ut-ras/pb-HW/(list of files, cad)

Other CAD files:
Bots/body v10.f3d
Bots/body v9.f3d
Bots/body2.0 v4.f3d
Bots/coupler2.0 v6.f3d
Bots/coupler2.0copy v2.f3d
Bots/midbody v7.f3d
Bots/stage0 v2.f3d
Bots/topbody v6.f3d
