ut-ras/pb-HW/Boards/tests/MC-test-simple.brd

## EAGLE design Boards/tests/MC-test-simple.brd (2018-04-29)

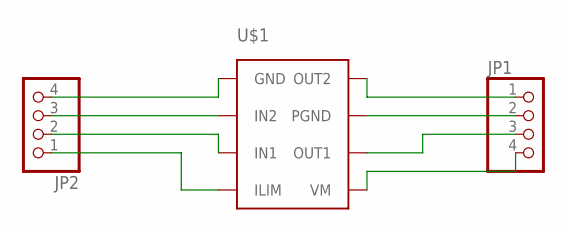
[picture p3: schematic MC-test-simple.sch]

Parts:
JP1, JP2: PINHD-1X4; 1X04
U$1: DRV8871; SO-8_POWERPAD

Connections:
GND: JP1.2, JP2.4, U$1.1 (GND), U$1.7 (PGND)
ILIM: JP2.1, U$1.4 (ILIM)
IN1: JP2.2, U$1.3 (IN1)
IN2: JP2.3, U$1.2 (IN2)
OUT1: JP1.3, U$1.6 (OUT1)
OUT2: JP1.1, U$1.8 (OUT2)
VM: JP1.4, U$1.5 (VM)

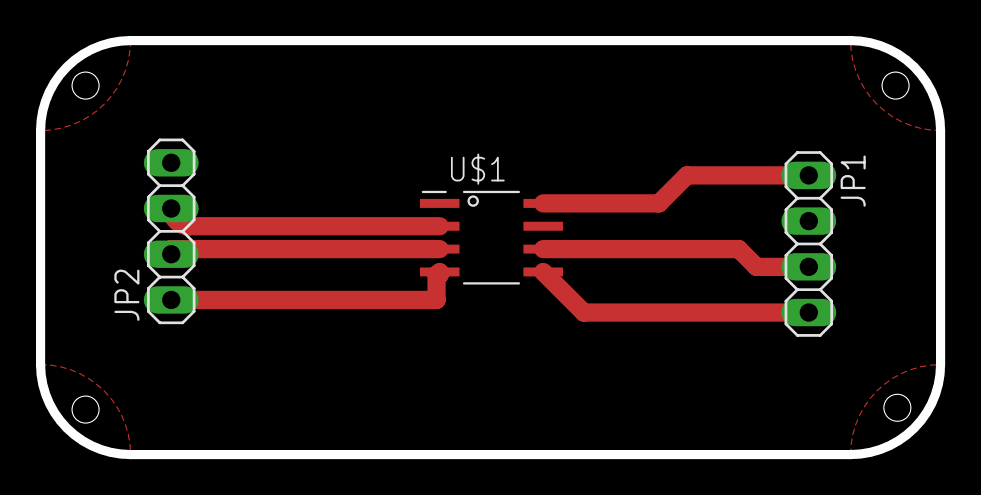
[picture p4: board MC-test-simple.brd from above]

Board: 2 copper layers, 50.0 x 23.0 mm, 3 parts (0 on the bottom side), 7 nets.
