ut-ras/pb-HW/Boards/robot/S1.brd

## EAGLE design Boards/robot/S1.brd (2018-04-29)

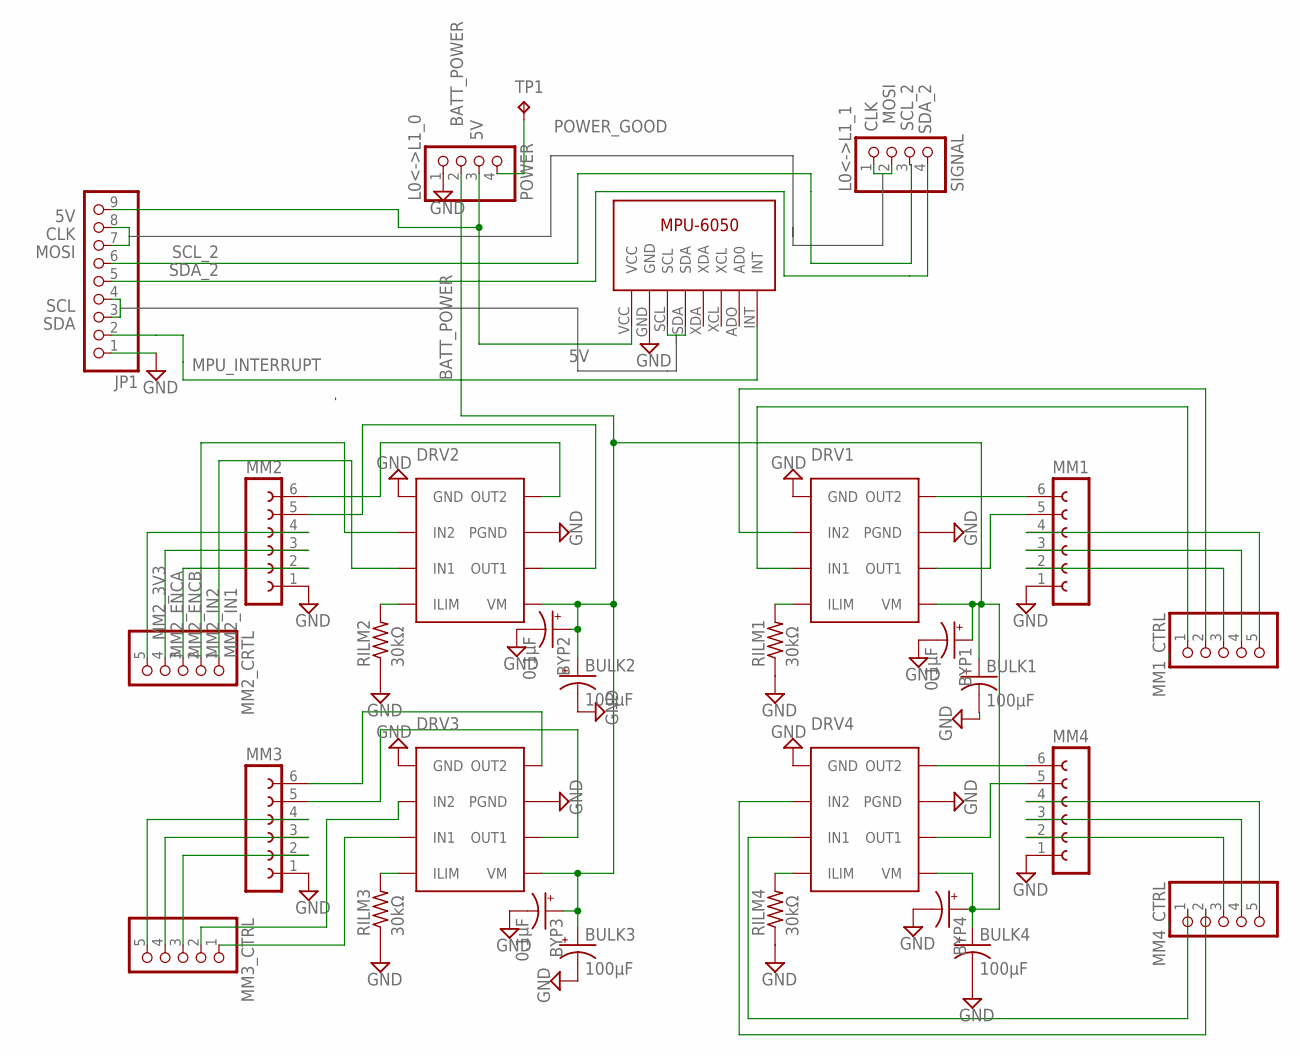
[picture p5: schematic S1.sch]

Parts:
BULK1, BULK2, BULK3, BULK4: 100μF; 153CLV-0605
BYP1, BYP2, BYP3: 0.1µF; A/3216-18R
BYP4: CPOL-USA/3216-18R; A/3216-18R
DRV1, DRV2, DRV3, DRV4: DRV8871; SO-8_POWERPAD
JP1: PINHD-1X9; 1X09
L0<->L1_0: POWER; 1X04/90
L0<->L1_1: SIGNAL; 1X04/90
MM1, MM2, MM3, MM4: FE06-1; FE06
MM1_CTRL, MM2_CRTL, MM3_CTRL, MM4_CTRL: PINHD-1X5; 1X05
RILM1, RILM2, RILM3, RILM4: 30kΩ; M1206
TP1: TPTP18R; TP18R
U$1: GY-521_MPUP6050; GY-521

Connections:
5V: JP1.9, L0<->L1_0.3, U$1.VCC
BATT_POWER: BULK1.+, BULK2.+, BULK3.+, BULK4.+, BYP1.+, BYP2.+, BYP3.+, BYP4.+, DRV1.5 (VM), DRV2.5 (VM), DRV3.5 (VM), DRV4.5 (VM), L0<->L1_0.2
CLK: JP1.8, L0<->L1_1.1
GND: BULK1.-, BULK2.-, BULK3.-, BULK4.-, BYP1.-, BYP2.-, BYP3.-, BYP4.-, DRV1.1 (GND), DRV1.7 (PGND), DRV2.1 (GND), DRV2.7 (PGND), DRV3.1 (GND), DRV3.7 (PGND), DRV4.1 (GND), DRV4.7 (PGND), JP1.1, L0<->L1_0.1, MM1.1, MM2.1, MM3.1, MM4.1, RILM1.1, RILM2.1, RILM3.1, RILM4.1, U$1.GND
IN1: DRV4.3 (IN1), MM4_CTRL.1
IN2: DRV4.2 (IN2), MM4_CTRL.2
MM2_3V3: MM2.4, MM2_CRTL.5
MM2_ENCA: MM2.3, MM2_CRTL.4
MM2_ENCB: MM2.2, MM2_CRTL.3
MM2_IN1: DRV2.3 (IN1), MM2_CRTL.1
MM2_IN2: DRV2.2 (IN2), MM2_CRTL.2
MOSI: JP1.7, L0<->L1_1.2
MPU_INTERRUPT: JP1.2, U$1.INT
unnamed: DRV3.4 (ILIM), RILM3.2
unnamed: DRV2.4 (ILIM), RILM2.2
unnamed: DRV1.4 (ILIM), RILM1.2
unnamed: DRV4.4 (ILIM), RILM4.2
unnamed: DRV4.8 (OUT2), MM4.6
unnamed: DRV3.6 (OUT1), MM3.5
unnamed: MM3.4, MM3_CTRL.5
unnamed: MM3.3, MM3_CTRL.4
unnamed: MM1.4, MM1_CTRL.5
unnamed: MM4.2, MM4_CTRL.3
unnamed: MM3.2, MM3_CTRL.3
unnamed: MM4.4, MM4_CTRL.5
unnamed: DRV2.8 (OUT2), MM2.6
unnamed: DRV2.6 (OUT1), MM2.5
unnamed: DRV3.8 (OUT2), MM3.6
unnamed: DRV4.6 (OUT1), MM4.5
unnamed: DRV1.6 (OUT1), MM1.5
unnamed: DRV1.8 (OUT2), MM1.6
unnamed: DRV3.2 (IN2), MM3_CTRL.2
unnamed: DRV3.3 (IN1), MM3_CTRL.1
unnamed: MM1.3, MM1_CTRL.4
unnamed: MM1.2, MM1_CTRL.3
unnamed: DRV1.2 (IN2), MM1_CTRL.2
unnamed: DRV1.3 (IN1), MM1_CTRL.1
unnamed: MM4.3, MM4_CTRL.4
POWER_GOOD: L0<->L1_0.4, TP1.TP
SCL: JP1.4, U$1.SCL
SCL_2: JP1.6, L0<->L1_1.3
SDA: JP1.3, U$1.SDA
SDA_2: JP1.5, L0<->L1_1.4

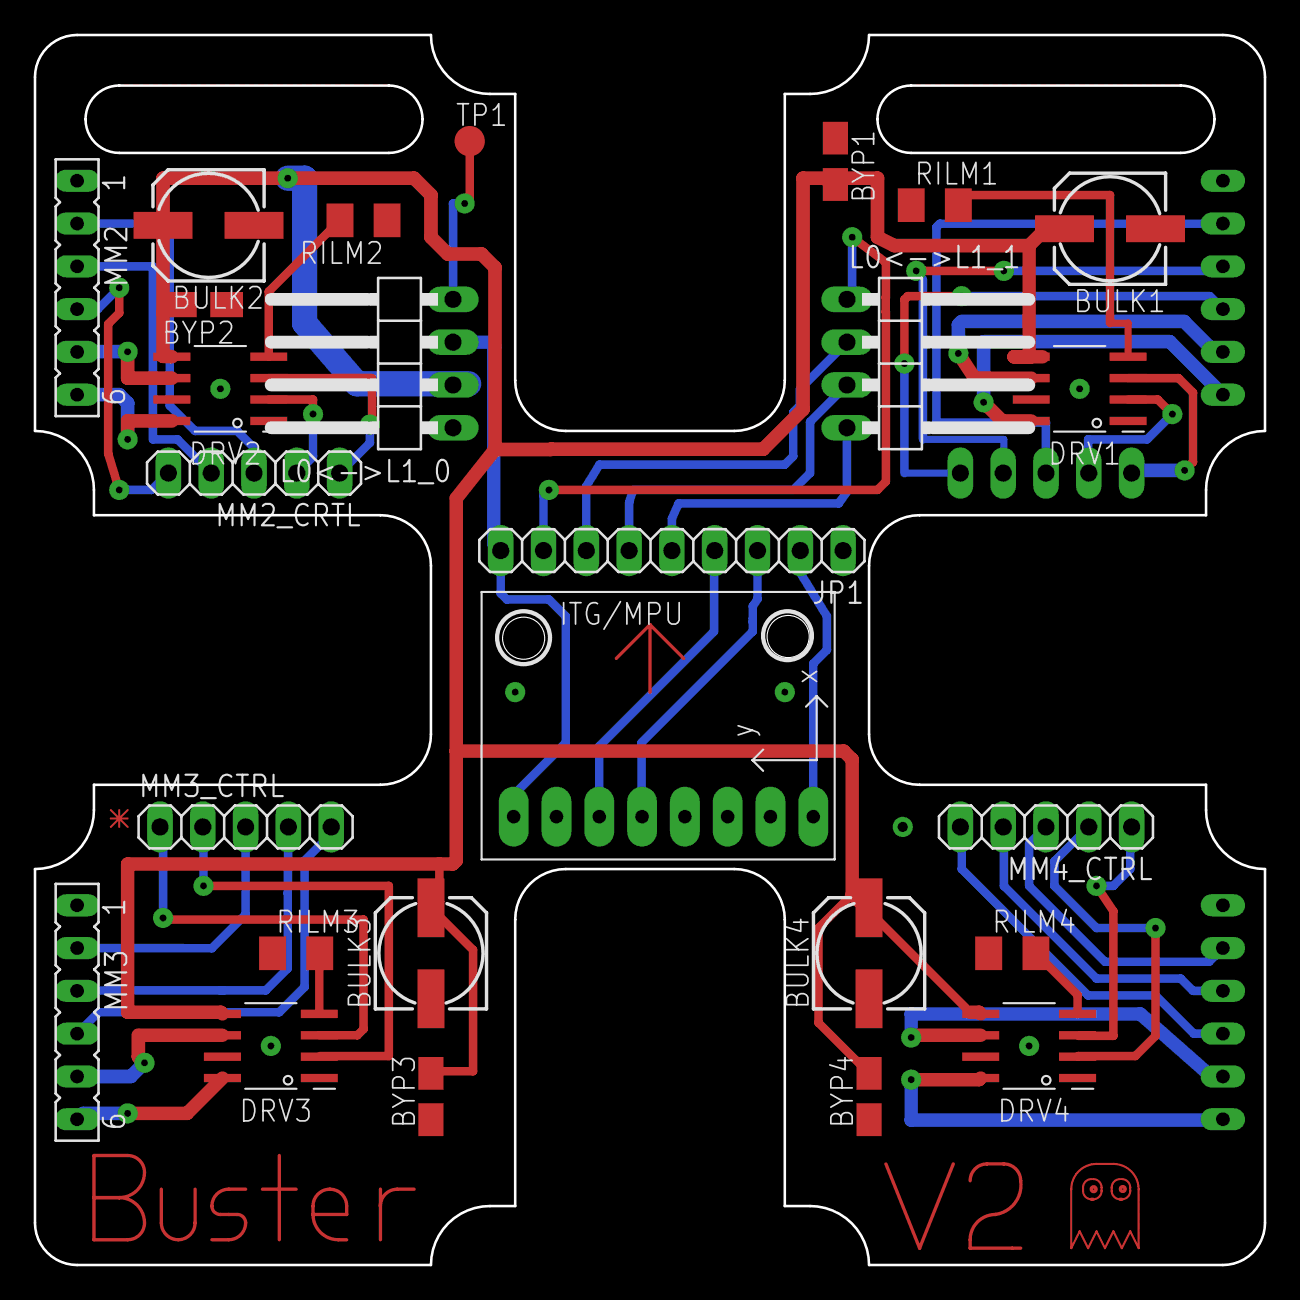
[picture p6: board S1.brd from above]

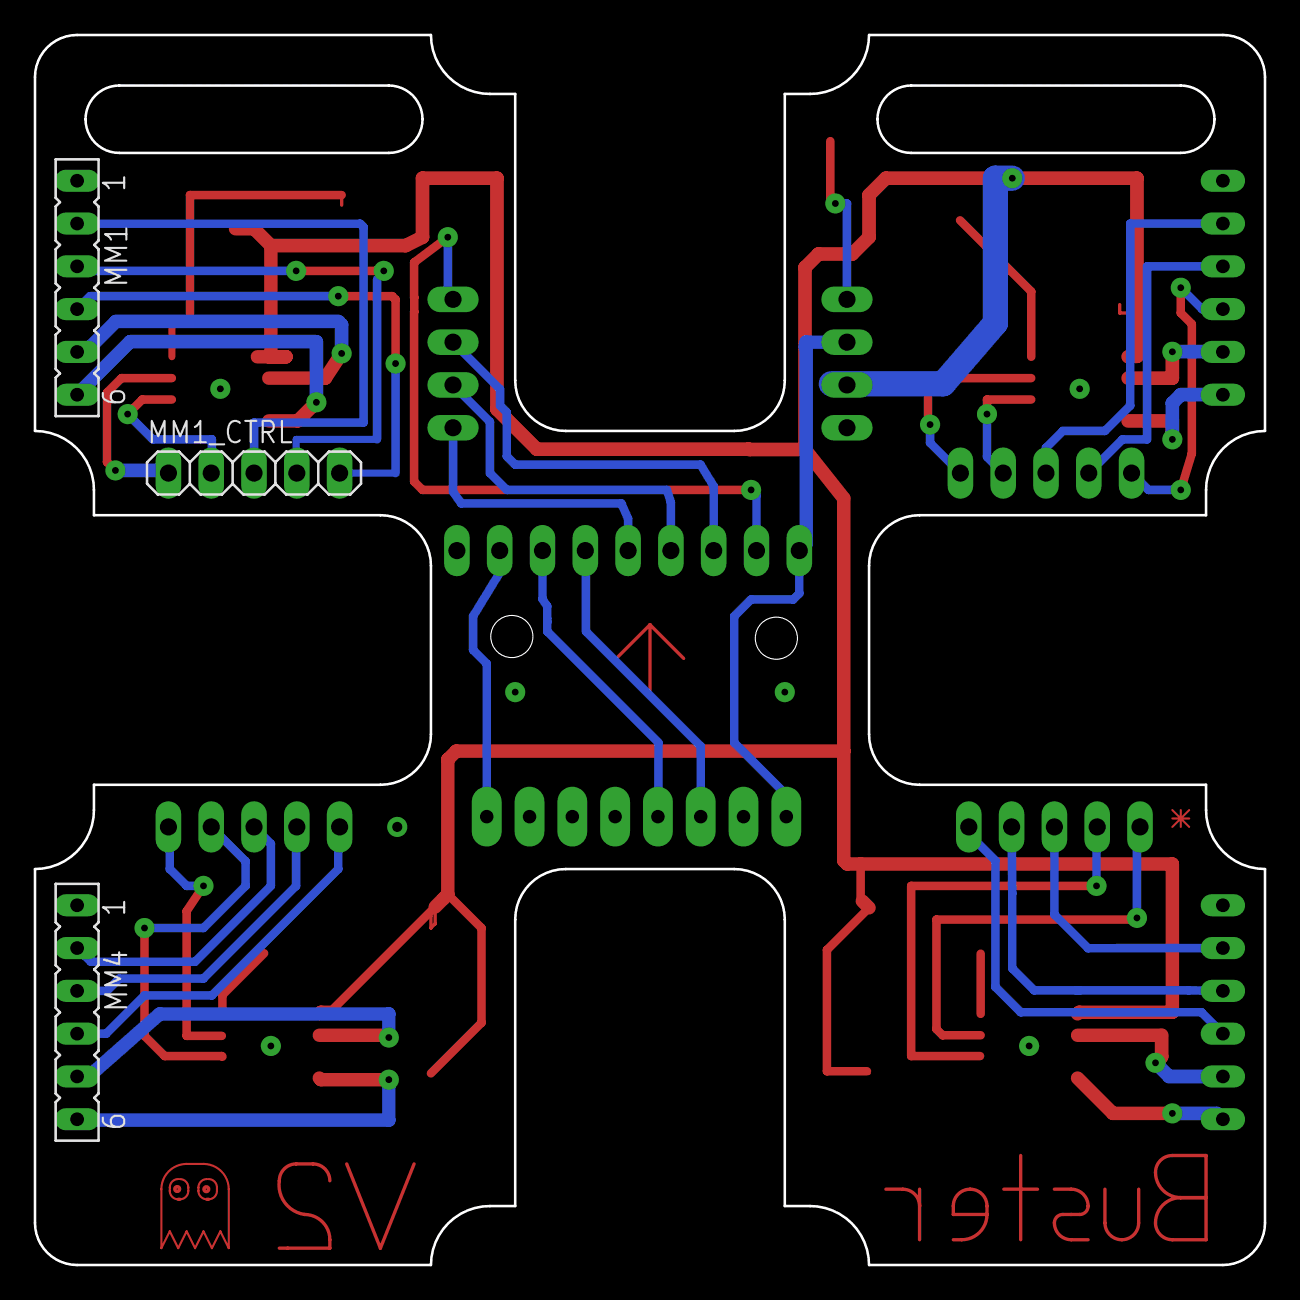
[picture p7: board S1.brd from below]

Board: 2 copper layers, 73.0 x 73.0 mm, 29 parts (3 on the bottom side), 43 nets.
