ut-ras/pb-HW/Boards/tests/MC-test.brd

## EAGLE design Boards/tests/MC-test.brd (2018-04-29)

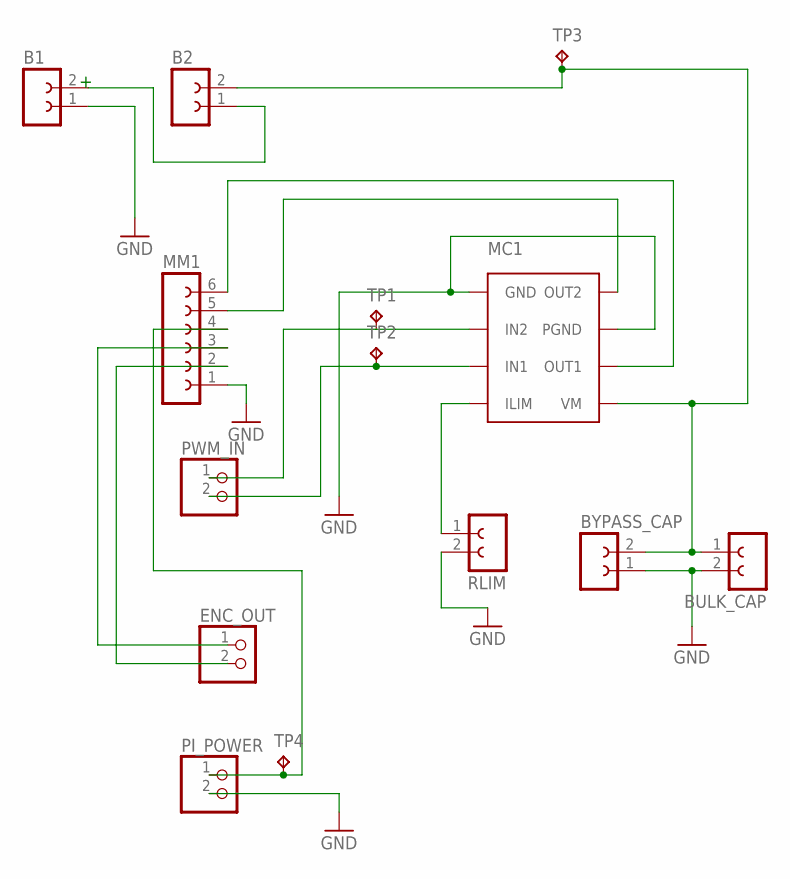
[picture p8: schematic MC-test.sch]

Parts:
B1, B2: FH_02X01
BULK_CAP: FH_02X01
BYPASS_CAP: FH_02X01
ENC_OUT: PINHD-1X2; 1X02
MC1: DRV8871; SO-8_POWERPAD
MM1: FE06-1; FE06
PI_POWER: PINHD-1X2; 1X02
PWM_IN: PINHD-1X2; 1X02
RLIM: FH_02X01
TP1, TP2, TP3, TP4: TPTP15SQ; TP15SQ

Connections:
3.3V: MM1.4, PI_POWER.1, TP4.TP
GND: B1.1, BULK_CAP.2, BYPASS_CAP.1, MC1.1 (GND), MC1.7 (PGND), MM1.1, PI_POWER.2, RLIM.2
M+: MC1.8 (OUT2), MM1.5
unnamed: ENC_OUT.1, MM1.3
unnamed: MC1.6 (OUT1), MM1.6
unnamed: B1.2, B2.1
unnamed: B2.2, BULK_CAP.1, BYPASS_CAP.2, MC1.5 (VM), TP3.TP
unnamed: MC1.4 (ILIM), RLIM.1
unnamed: ENC_OUT.2, MM1.2
unnamed: MC1.3 (IN1), PWM_IN.2, TP2.TP
unnamed: MC1.2 (IN2), PWM_IN.1, TP1.TP

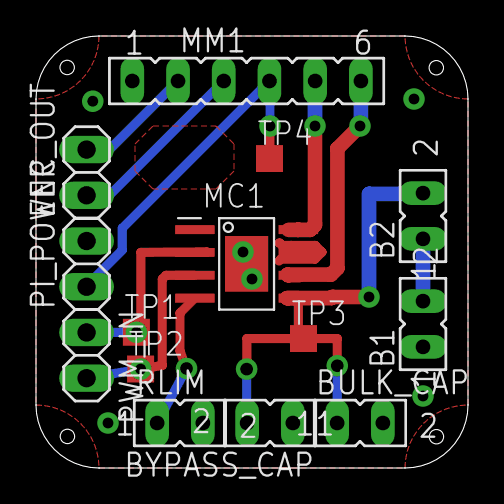
[picture p9: board MC-test.brd from above]

Board: 2 copper layers, 24.0 x 24.0 mm, 14 parts (0 on the bottom side), 11 nets.
