ut-ras/pb-HW/Boards/robot/S0.brd

## EAGLE design Boards/robot/S0.brd (2018-04-29)

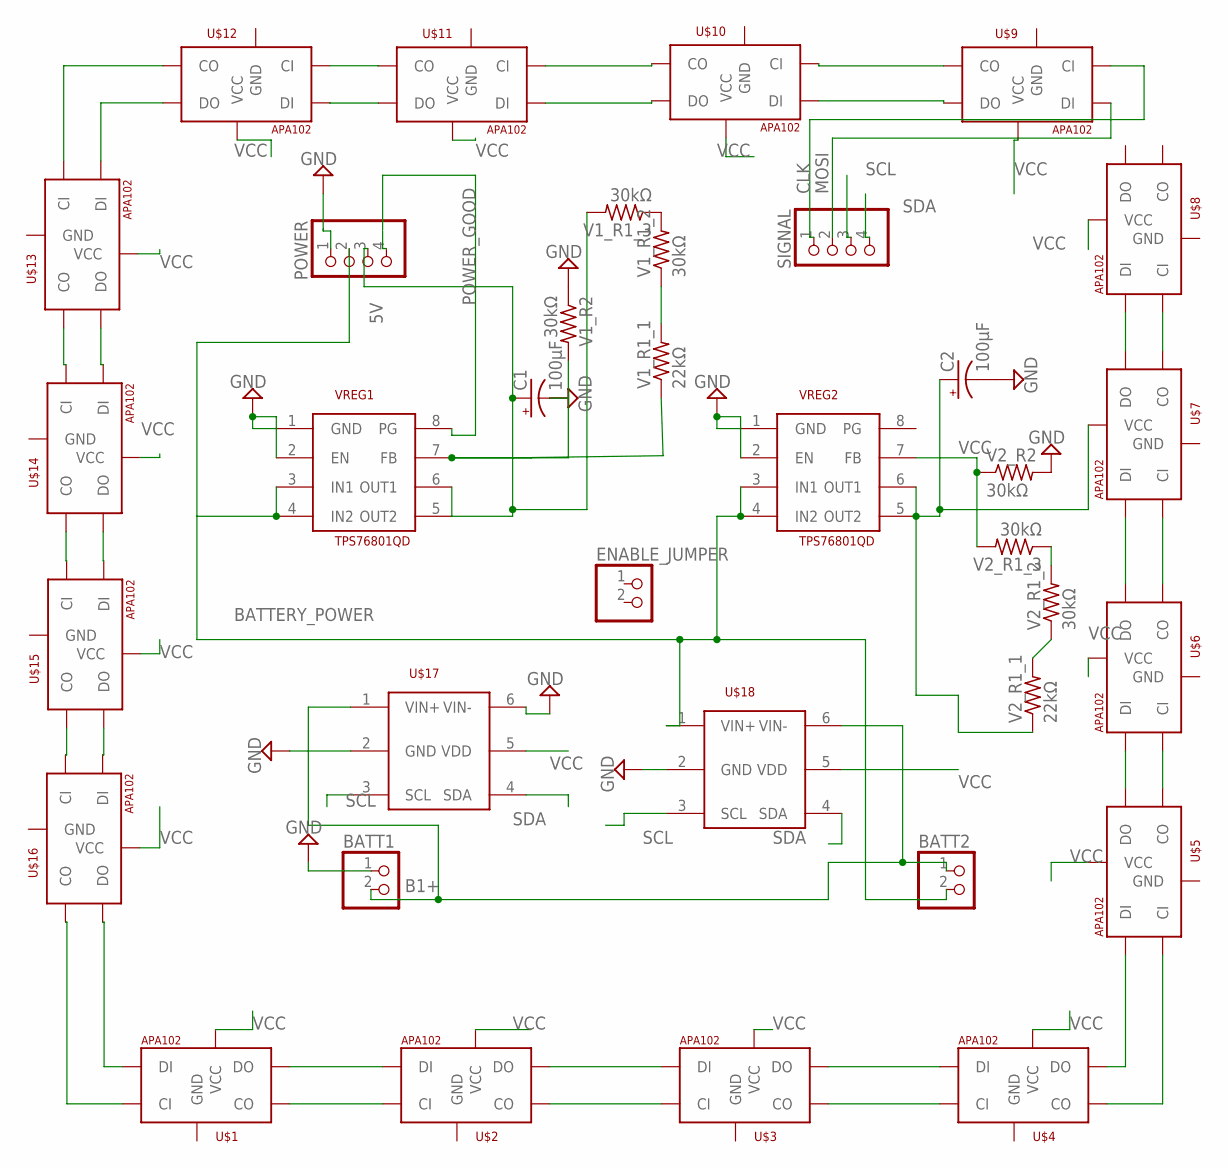
[picture p10: schematic S0.sch]

Parts:
BATT1, BATT2: PINHD-1X2/90; 1X02/90
C1, C2: 100µF; D/7343-31R
ENABLE_JUMPER: PINHD-1X2/90; 1X02/90
POWER: PINHD-1X4; 1X04
SIGNAL: PINHD-1X4; 1X04
U$1, U$2, U$3, U$4, U$5, U$6, U$7, U$8, U$9, U$10, U$11, U$12, U$13, U$14, U$15, U$16: APA1025050; APA102_5050
U$17: ADS1000BD0; SOT-23-6-DBV
U$18: ADS1000BD1; SOT-23-6-DBV
V1_R1_1, V2_R1_1: 22kΩ; R0402
V1_R1_2, V1_R1_3, V1_R2, V2_R1_2, V2_R1_3, V2_R2: 30kΩ; M1206
VREG1, VREG2: TPS76801QD; SO-8_POWERPAD

Connections:
5V: C1.+, POWER.3, V1_R1_3.2, VREG1.5 (OUT2), VREG1.6 (OUT1)
B1+: BATT1.2, BATT2.1, U$17.1 (VIN+), U$18.6 (VIN-)
BATTERY_POWER: BATT2.2, POWER.2, U$18.1 (VIN+), VREG1.3 (IN1), VREG1.4 (IN2), VREG2.3 (IN1), VREG2.4 (IN2)
CLK: SIGNAL.1, U$9.5 (CI)
GND: BATT1.1, C1.-, C2.-, POWER.1, U$1.6 (GND), U$2.6 (GND), U$3.6 (GND), U$4.6 (GND), U$5.6 (GND), U$6.6 (GND), U$7.6 (GND), U$8.6 (GND), U$9.6 (GND), U$10.6 (GND), U$11.6 (GND), U$12.6 (GND), U$13.6 (GND), U$14.6 (GND), U$15.6 (GND), U$16.6 (GND), U$17.2 (GND), U$17.6 (VIN-), U$18.2 (GND), V1_R2.1, VREG1.1 (GND), VREG1.2 (EN), VREG2.1 (GND), VREG2.2 (EN)
MOSI: SIGNAL.2, U$9.4 (DI)
unnamed: U$1.3 (DO), U$2.4 (DI)
unnamed: U$1.2 (CO), U$2.5 (CI)
unnamed: U$2.3 (DO), U$3.4 (DI)
unnamed: U$2.2 (CO), U$3.5 (CI)
unnamed: U$3.3 (DO), U$4.4 (DI)
unnamed: U$3.2 (CO), U$4.5 (CI)
unnamed: U$4.3 (DO), U$5.4 (DI)
unnamed: U$4.2 (CO), U$5.5 (CI)
unnamed: U$5.2 (CO), U$6.5 (CI)
unnamed: U$5.3 (DO), U$6.4 (DI)
unnamed: U$6.3 (DO), U$7.4 (DI)
unnamed: U$6.2 (CO), U$7.5 (CI)
unnamed: U$7.2 (CO), U$8.5 (CI)
unnamed: U$7.3 (DO), U$8.4 (DI)
unnamed: U$1.5 (CI), U$16.2 (CO)
unnamed: U$1.4 (DI), U$16.3 (DO)
unnamed: U$9.3 (DO), U$10.4 (DI)
unnamed: U$9.2 (CO), U$10.5 (CI)
unnamed: U$10.2 (CO), U$11.5 (CI)
unnamed: U$10.3 (DO), U$11.4 (DI)
unnamed: U$11.2 (CO), U$12.5 (CI)
unnamed: U$11.3 (DO), U$12.4 (DI)
unnamed: U$12.2 (CO), U$13.5 (CI)
unnamed: U$12.3 (DO), U$13.4 (DI)
unnamed: U$13.3 (DO), U$14.4 (DI)
unnamed: U$13.2 (CO), U$14.5 (CI)
unnamed: U$14.3 (DO), U$15.4 (DI)
unnamed: U$14.2 (CO), U$15.5 (CI)
unnamed: U$15.2 (CO), U$16.5 (CI)
unnamed: U$15.3 (DO), U$16.4 (DI)
unnamed: V2_R1_2.2, V2_R1_3.1
unnamed: V1_R1_1.2, V1_R1_2.1
unnamed: V1_R1_1.1, V1_R2.2, VREG1.7 (FB)
unnamed: V1_R1_2.2, V1_R1_3.1
unnamed: V2_R1_1.2, V2_R1_2.1
unnamed: V2_R1_3.2, V2_R2.1, VREG2.7 (FB)
POWER_GOOD: POWER.4, VREG1.8 (PG)
SCL: SIGNAL.3, U$17.3 (SCL), U$18.3 (SCL)
SDA: SIGNAL.4, U$17.4 (SDA), U$18.4 (SDA)
VCC: C2.+, U$1.1 (VCC), U$2.1 (VCC), U$3.1 (VCC), U$4.1 (VCC), U$5.1 (VCC), U$6.1 (VCC), U$7.1 (VCC), U$8.1 (VCC), U$9.1 (VCC), U$10.1 (VCC), U$11.1 (VCC), U$12.1 (VCC), U$13.1 (VCC), U$14.1 (VCC), U$15.1 (VCC), U$16.1 (VCC), U$17.5 (VDD), U$18.5 (VDD), V2_R1_1.1, VREG2.5 (OUT2), VREG2.6 (OUT1)

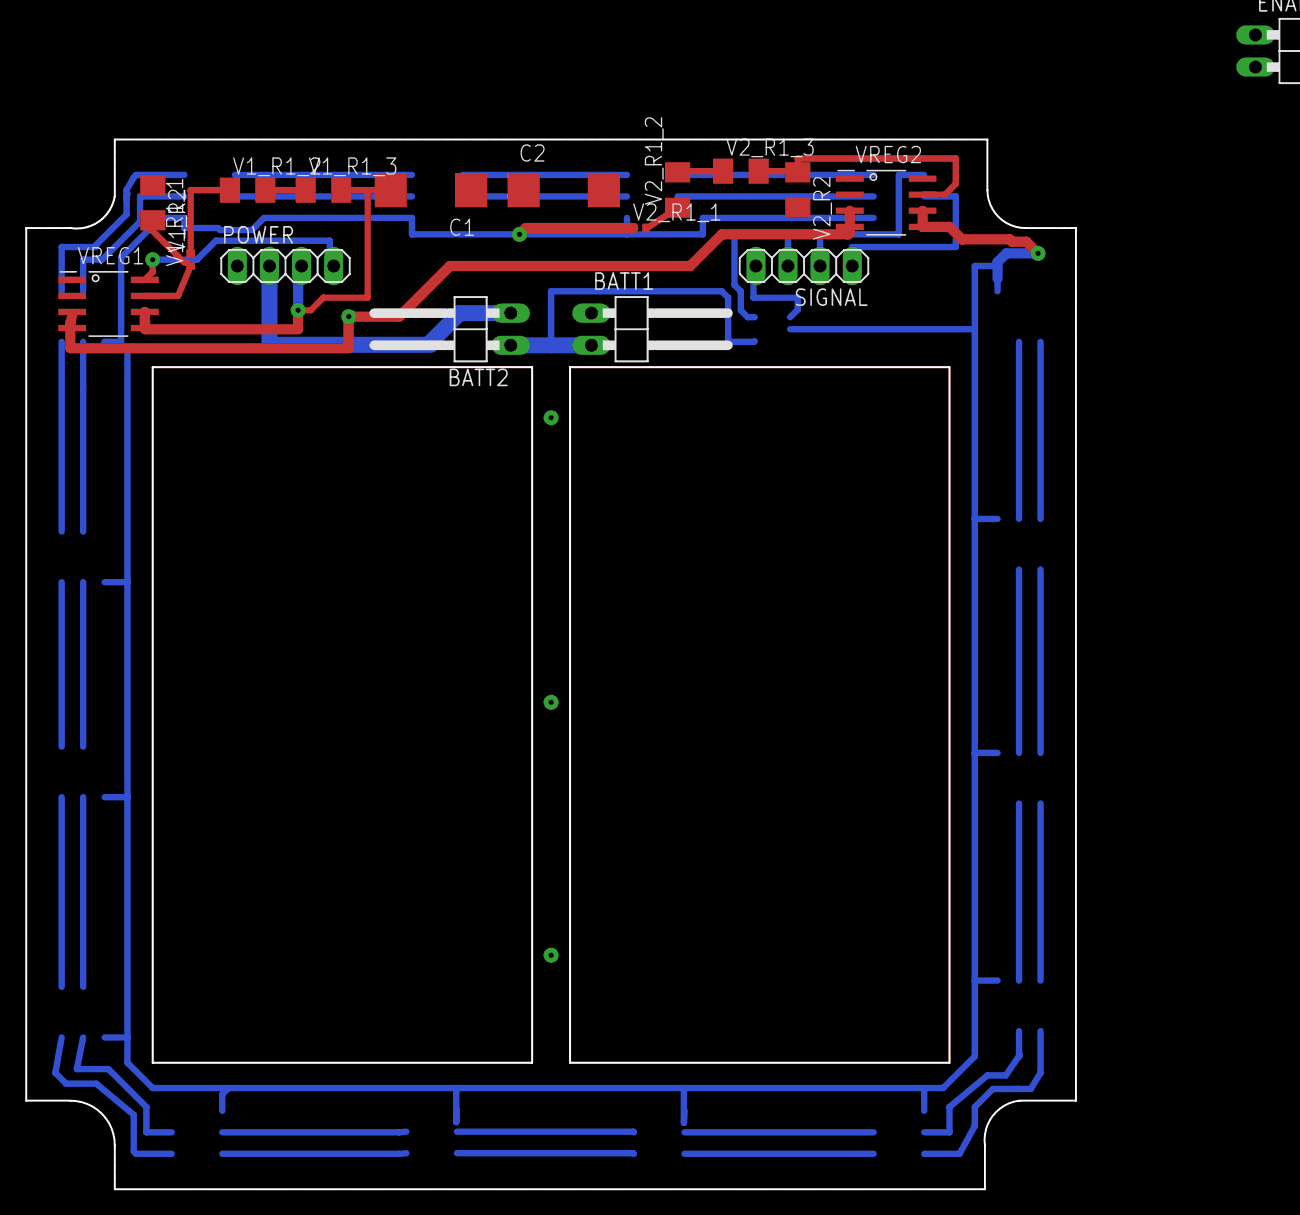
[picture p11: board S0.brd from above]

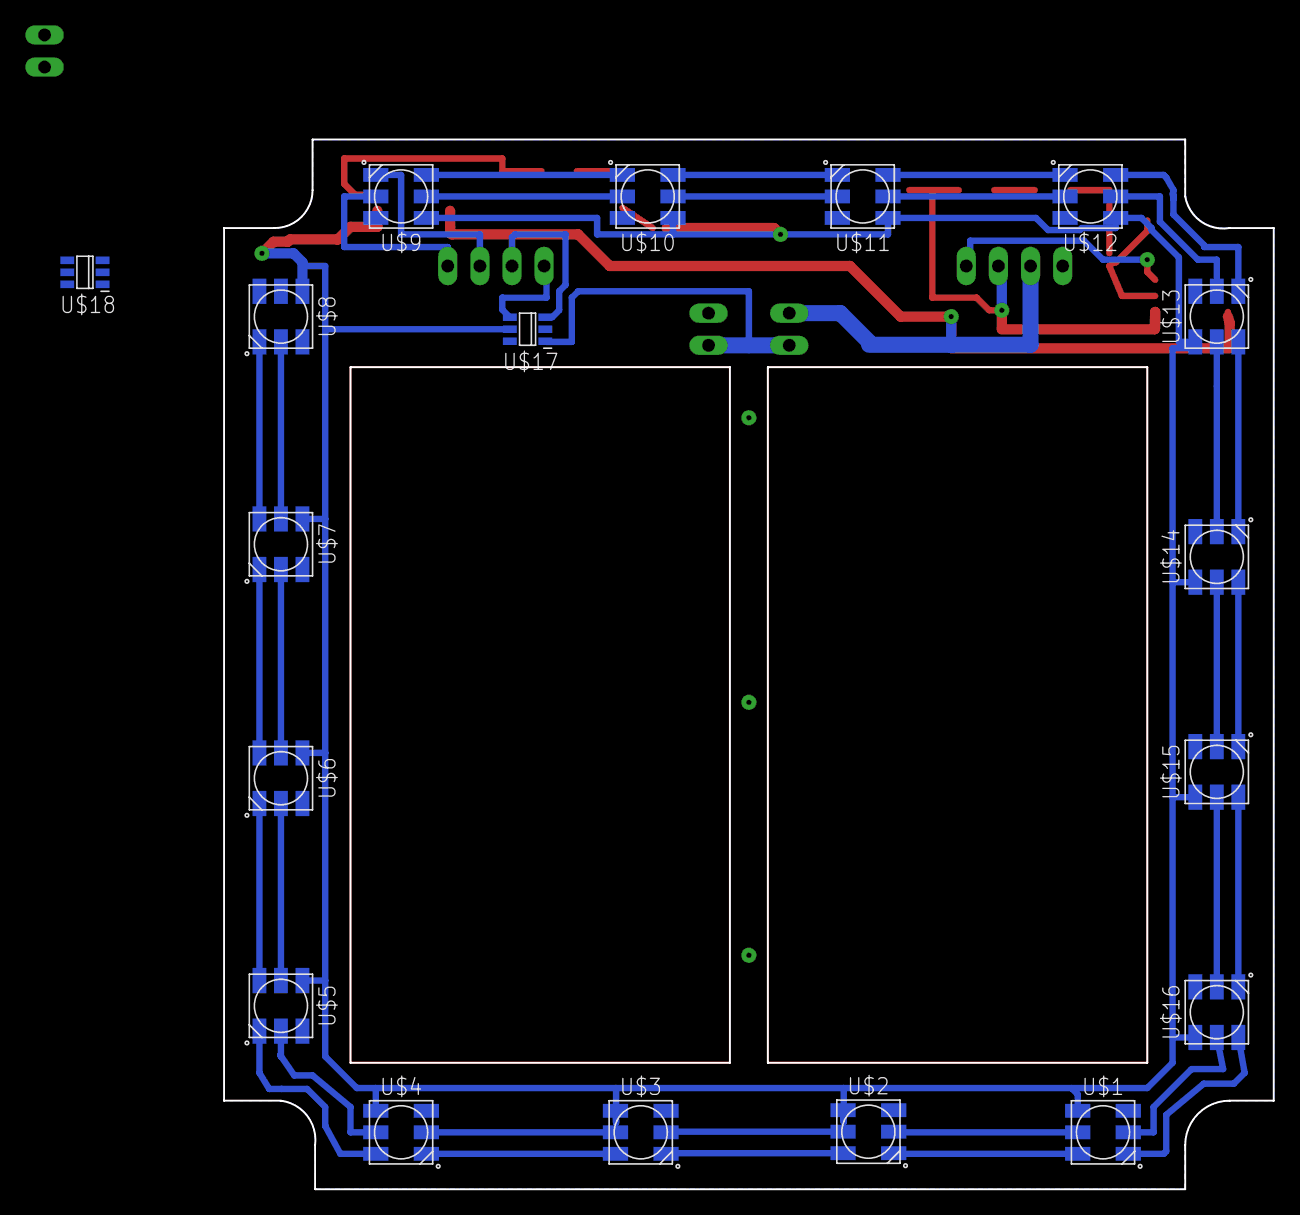
[picture p12: board S0.brd from below]

Board: 2 copper layers, 83.0 x 83.0 mm, 35 parts (18 on the bottom side), 46 nets.
