ut-ras/pb-HW/(commit log)

2018-04-29 Overengineered DRV8871 Test Board
    It didn't literally go up in flames but we got pretty close
    [MC-test.brd, MC-test.sch]
2018-04-29 A glorified DRV8871 breakout
    (it works!)
    [MC-test-simple.brd, MC-test-simple.sch]
2018-04-29 Stage 1 of Buster
    Hacky and a manufacturing nightmare but undeniably functional
    [S1.brd, S1.sch]
2018-04-29 The mostly complete vision for Buster V2's Stage 0
    (has the enable jumper + the 2nd ADC)
    [S0.brd, S0.sch]
2018-04-29 The reduced version of the Stage 0 PCB
    Functional-ish? ADC was never tested, lights were scorchy (probably because of the TPS) and caps are probably wrong (ESR too high).
    Makes a very spiffy battery carriage however.
    [S0R.brd, S0R.sch]
2018-04-29 The (incomplete) Stage 2 PCB from Miguel
    Never finished, but a valiant effort nonetheless
    [Stage2_V2.sch]
2018-04-29 Add updated version of the Parts library
    Contains:
    - ADS1000
    - APA102
    - BQ28Z610
    - MPU6050 (GY-521 breakout)
    - RPi Zero
    - TPS76801QD
    - Other misc connectors
2018-04-29 Kanishka's Fusion 360 files from GDrive
    Eventually these should be .stls
    [body v10.f3d, body v9.f3d, body2.0 v4.f3d, coupler2.0 v6.f3d, coupler2.0copy v2.f3d, midbody v7.f3d, stage0 v2.f3d, topbody v6.f3d]
